LTSpenny/ZANDVE/User_Mods/LTSPENNY/MISC_USEFUL/RS25-5_DIN_rail_-_final.stl

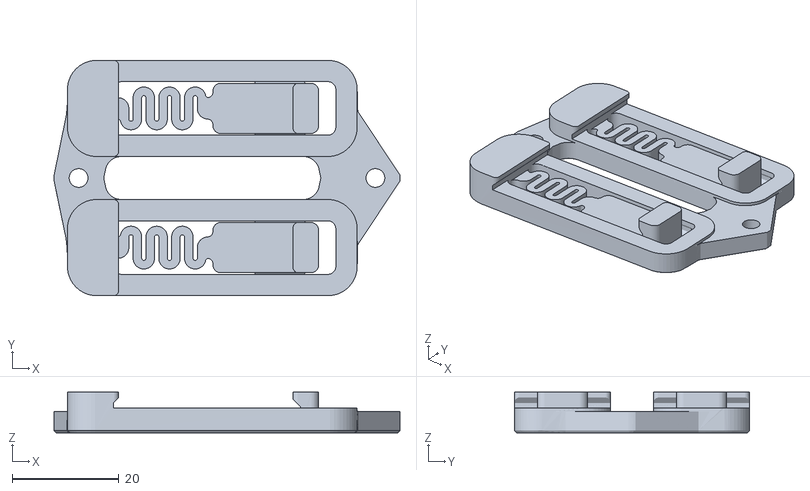
[picture p1: CAD file, 2023-04-22]
User_Mods/LTSPENNY/MISC_USEFUL/RS25-5_DIN_rail_-_final.stl
64.7 x 44.0 x 7.60
