LTSpenny/ZANDVE/User_Mods/LTSPENNY/ZANDVE/L_Stepper_Pillow_Bearing/STLs/Left_Stepper_Pillow_Block_Mod_Bearing_Stack_Final.stl

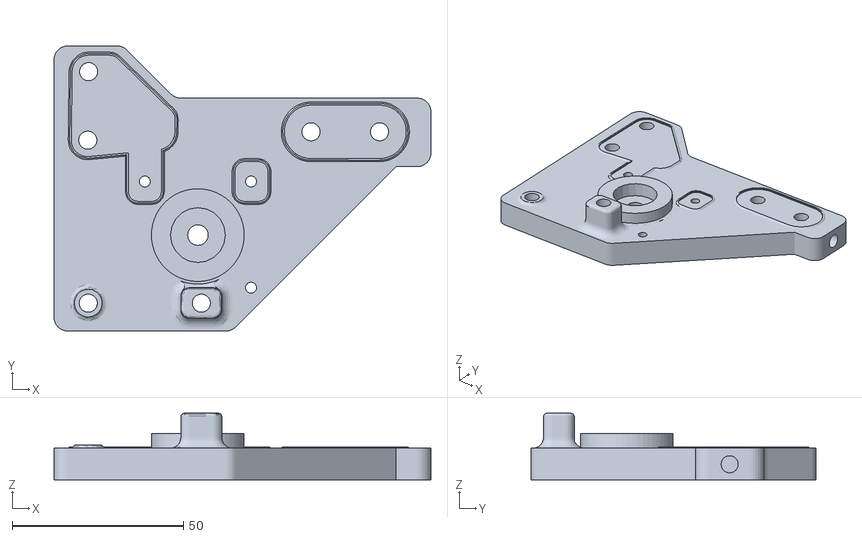
[picture p2: CAD file, 2023-04-18]
User_Mods/LTSPENNY/ZANDVE/L_Stepper_Pillow_Bearing/STLs/Left_Stepper_Pillow_Block_Mod_Bearing_Stack_Final.stl
110.0 x 83.2 x 19.5
