LTSpenny/ZANDVE/User_Mods/LTSPENNY/MISC_USEFUL/Wago_Rear_Corner_Mount_5X3.stl

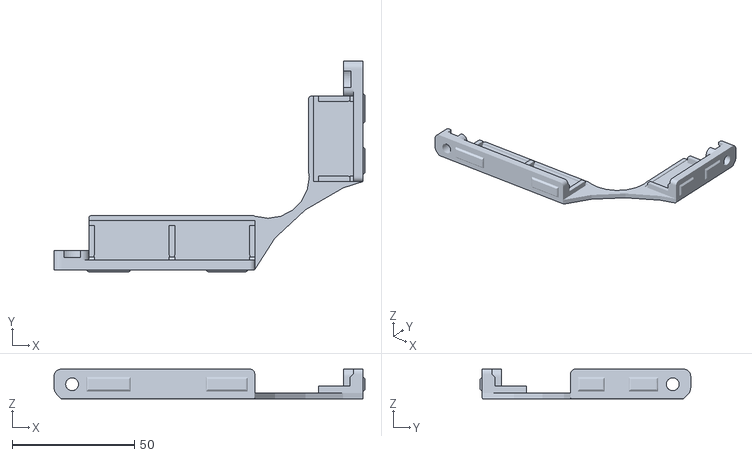
[picture p3: CAD file, 2023-04-22]
User_Mods/LTSPENNY/MISC_USEFUL/Wago_Rear_Corner_Mount_5X3.stl
127.3 x 86.2 x 12.2
