LTSpenny/ZANDVE/User_Mods/LTSPENNY/ZANDVE/L_Stepper_Pillow_Bearing/STLs/Right_Stepper_1_1_Bearing_Stack_Final.stl

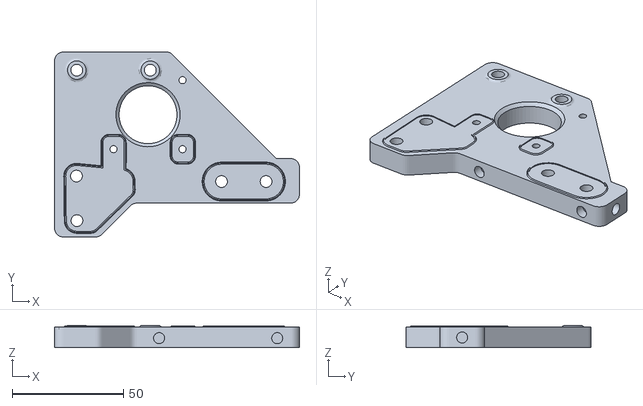
[picture p4: CAD file, 2023-04-14]
User_Mods/LTSPENNY/ZANDVE/L_Stepper_Pillow_Bearing/STLs/Right_Stepper_1_1_Bearing_Stack_Final.stl
110.0 x 83.1 x 10.00
